tommyfgj/clawnotify/stl_out/base_bottom_v18.stl

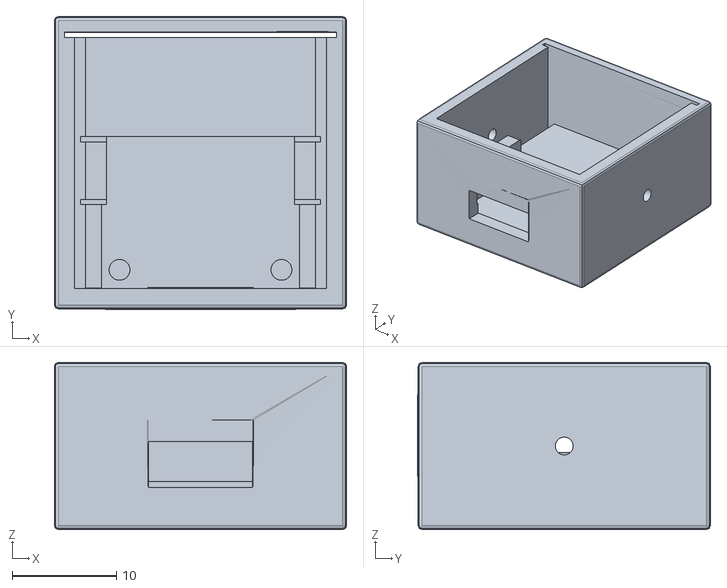
[picture p1: CAD file, 2026-04-23]
stl_out/base_bottom_v18.stl
28.0 x 28.1 x 16.0
