tommyfgj/clawnotify/stl_out/PushRod.stl

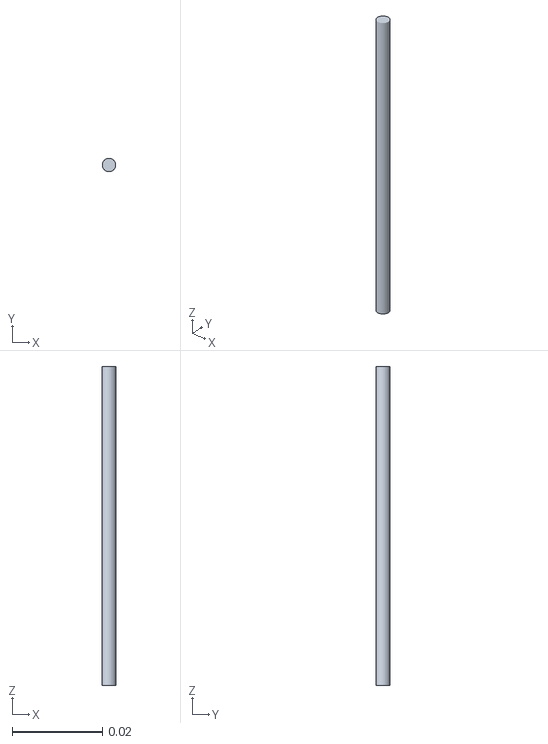
[picture p2: CAD file, 2026-04-23]
stl_out/PushRod.stl
0.003 x 0.003 x 0.0708
