tommyfgj/clawnotify/stl_out/Cover.stl

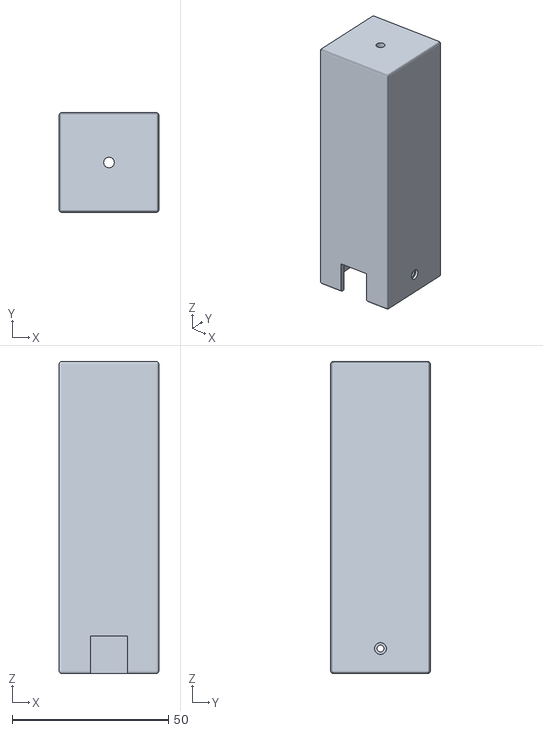
[picture p3: CAD file, 2026-04-23]
stl_out/Cover.stl
32.0 x 32.0 x 100.0
