tommyfgj/clawnotify/stl_out/ClaudeFoot.stl

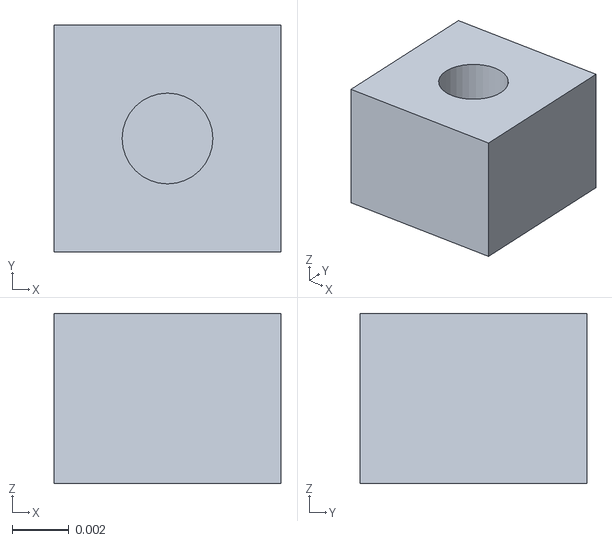
[picture p4: CAD file, 2026-04-23]
stl_out/ClaudeFoot.stl
0.008 x 0.008 x 0.006
