tommyfgj/clawnotify/stl_out/Base_Top_orig.stl

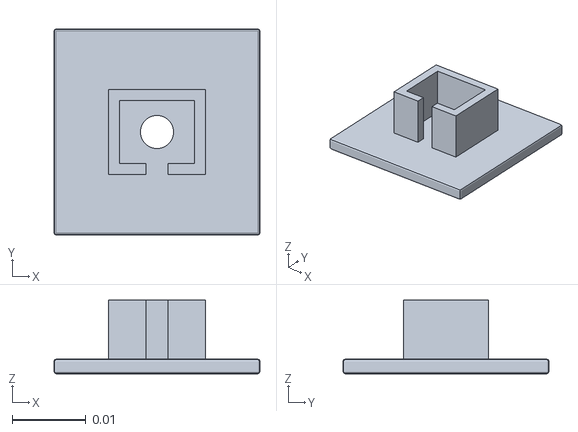
[picture p5: CAD file, 2026-04-23]
stl_out/Base_Top_orig.stl
0.028 x 0.028 x 0.01
