tommyfgj/clawnotify/stl_out/Base_Top.3mf

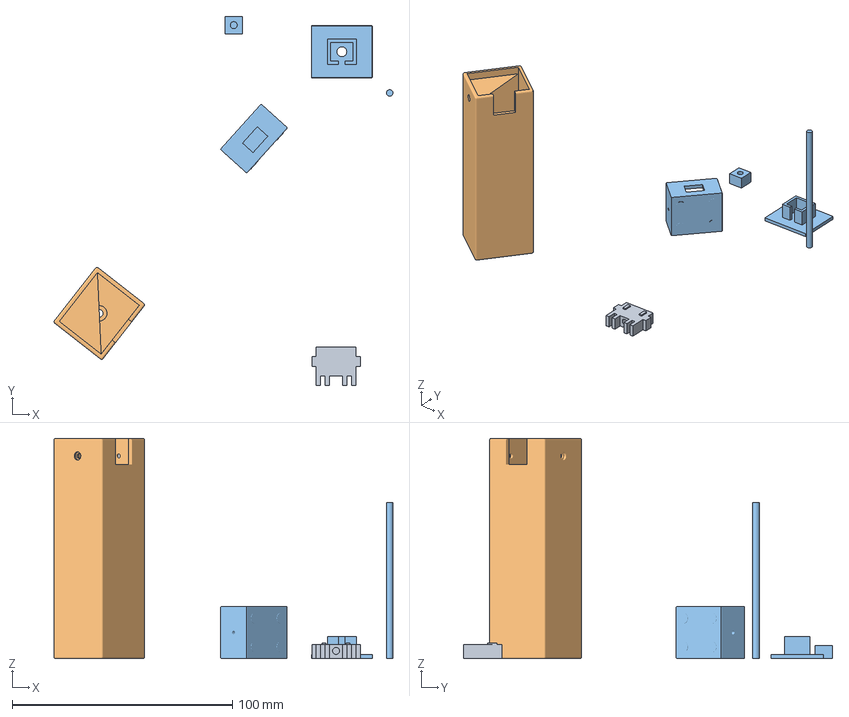
[picture p6: CAD file, 2026-04-23]
stl_out/Base_Top.3mf
153.8 x 167.6 x 100.0 mm
Invader.stl
Cover.stl
组合体
