tommyfgj/clawnotify/stl_out/Invader.stl

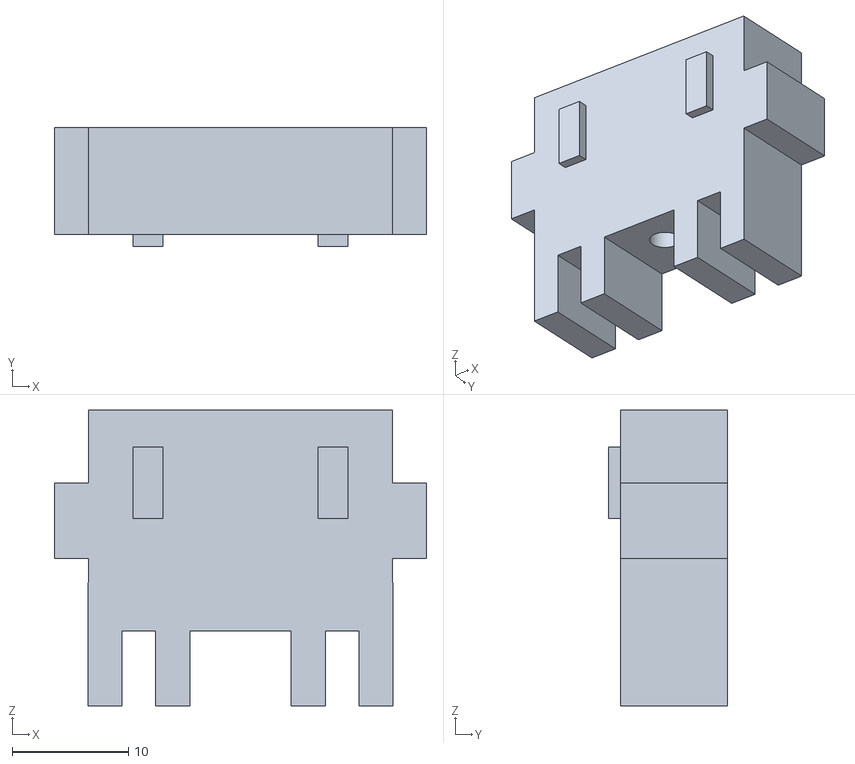
[picture p7: CAD file, 2026-04-23]
stl_out/Invader.stl
32.0 x 10.3 x 25.4
