tommyfgj/clawnotify/stl_out/Base_Bottom.stl

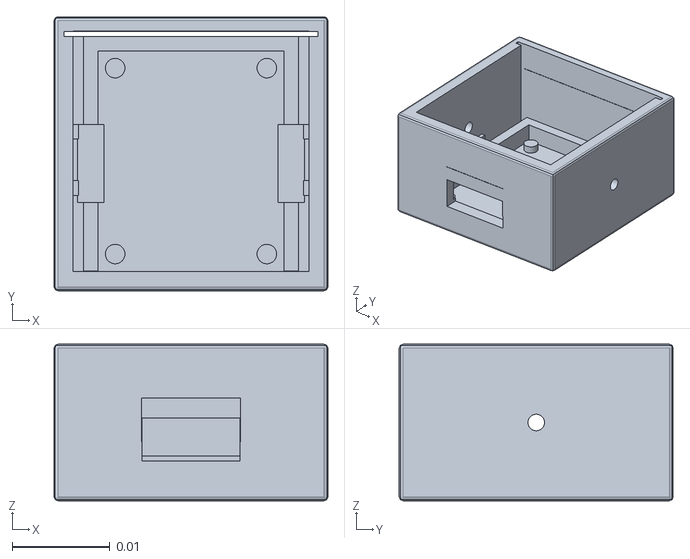
[picture p8: CAD file, 2026-04-23]
stl_out/Base_Bottom.stl
0.028 x 0.0281 x 0.016
