tommyfgj/clawnotify/stl_out/base_bottom_v16.stl

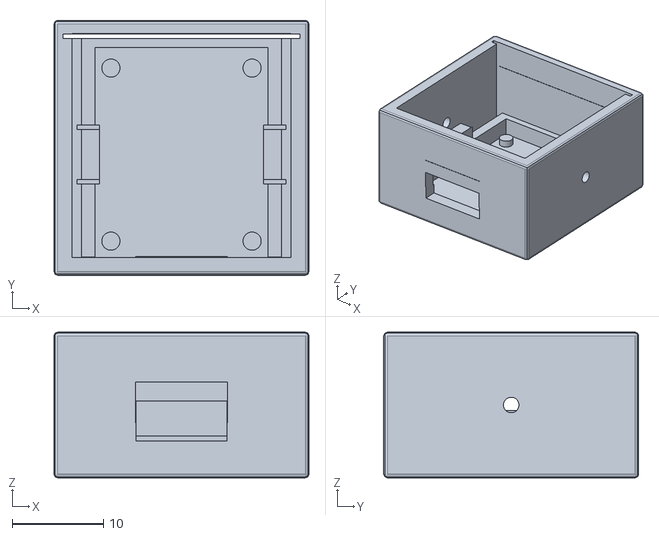
[picture p9: CAD file, 2026-04-23, an earlier design]
stl_out/base_bottom_v16.stl
28.0 x 28.1 x 16.0
