tommyfgj/clawnotify/stl_out/base_bottom_v17.stl

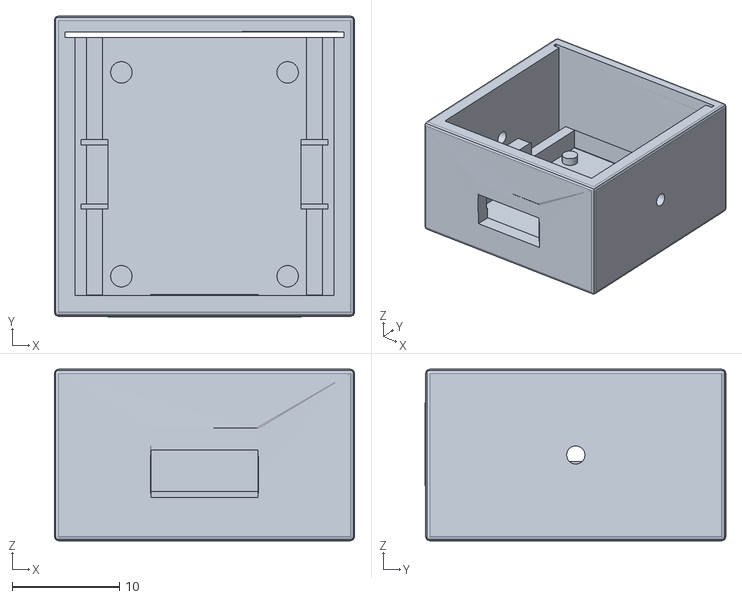
[picture p10: CAD file, 2026-04-23, an earlier design]
stl_out/base_bottom_v17.stl
28.0 x 28.1 x 16.0
