tommyfgj/clawnotify/(list of files, cad)

Other CAD files:
stl_out/base_bottom_v15.stl
stl_out/Base_Top.stl
