tommyfgj/clawnotify/(commit log)

2026-04-22 Initial commit: clawnotify — physical desktop notifier for AI agents
    - README with architecture, install, hook integration (Claude Code / Codebuddy / Cursor)
    - Firmware (agent_notifier.ino): serial-driven ESP32-C3, 3 hard safety limits
    - Host CLI (notify.py) + auto hook installer (install_hooks.py)
    - Smart-mute guard (should_notify.sh) for GUI agents; Claude Code always rings
    - Hardware assembly doc (ASSEMBLY.md) + wiring diagram (wiring.html)
2026-04-23 Add stl_out: 3D-printable STL/3MF assets
    [Base_Bottom.stl, Base_Top.3mf, Base_Top.stl, ClaudeFoot.stl, Cover.stl, Invader.stl, PushRod.stl, base_bottom_v15.stl]
2026-04-23 new bottom
    [Base_Top.stl, Base_Top_orig.stl]
